ericysun/FrontierTrailCam/TrailCam Case/Device Photos/openDeviceView2.png

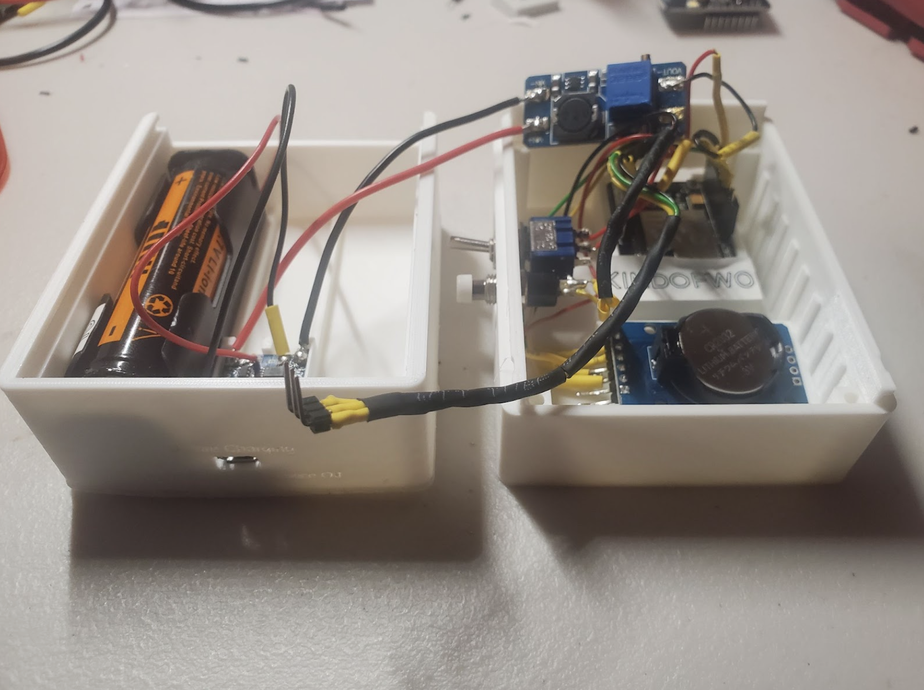
TrailCam Case/Device Photos/openDeviceView2.png
