ericysun/FrontierTrailCam/TrailCam Case/Device Photos/openDeviceView1.png

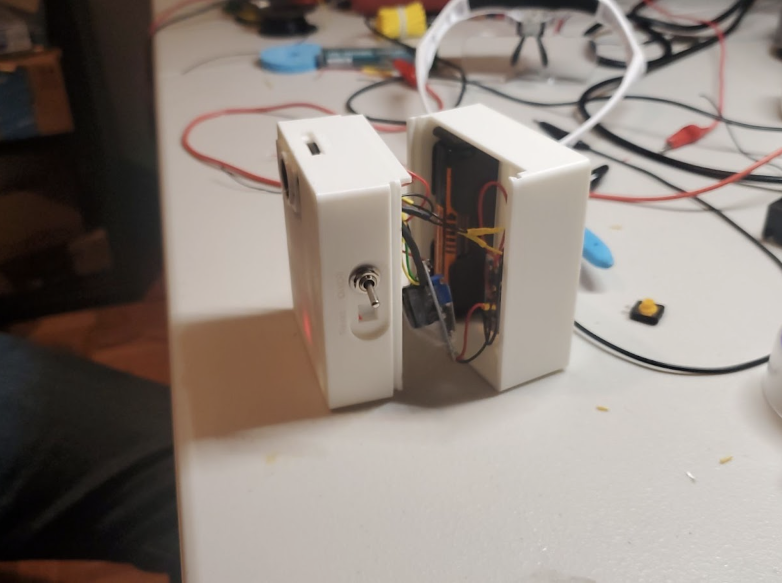
TrailCam Case/Device Photos/openDeviceView1.png
