ericysun/FrontierTrailCam/TrailCam Case/CAD Files/CameraCoverV5.obj

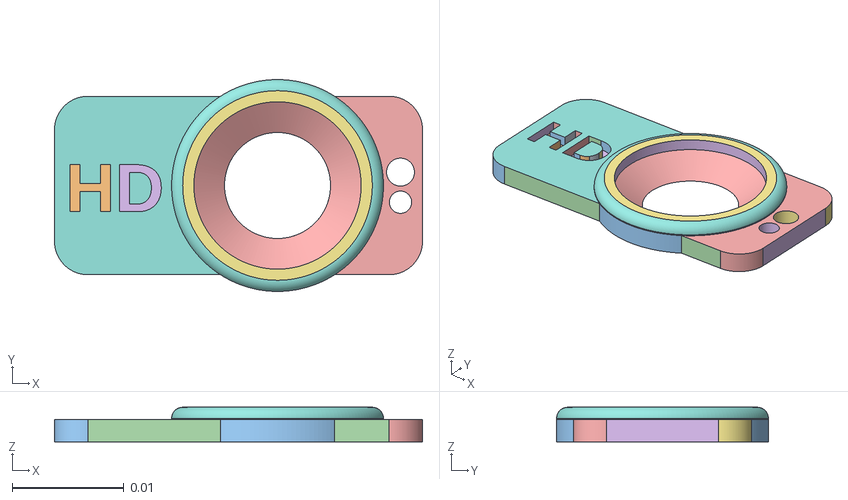
[picture p3: CAD file, 2024-10-31]
TrailCam Case/CAD Files/CameraCoverV5.obj
0.033 x 0.019 x 0.0031
