ericysun/FrontierTrailCam/(threads)

Thread 1 (2022-09-12):

Redirect to Web Server IP address for ESP-CAM

ericysun, 2022-09-12:
Set up Static IP: https://randomnerdtutorials.com/esp32-cam-static-fixed-ip-address-arduino/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,address%20as%20we%27ll%20explain.

Closed 2025-05-05.

Thread 2 (2022-09-12):

Photo Settings Page doesn't display previous settings

ericysun, 2022-09-12:
The photo settings page displays the current time as the start time and always displays "hour" as frequency, not reflecting the actual settings.

Closed 2025-05-04.

Thread 3 (2022-09-12):

Sleep Calculation not working for certain timezones

ericysun, 2022-09-12:
If the camera is used in an area with a with non-int difference from UTC in hours, the calculation for sleep time doesn't work. For example, if a timezone is UTC+1, it works, but if the timezone is UTC+1.5, it will not work.

Closed 2025-05-06.
