ericysun/FrontierTrailCam/TrailCam Case/Drafting Drawings/Battery Holder Drawing.pdf

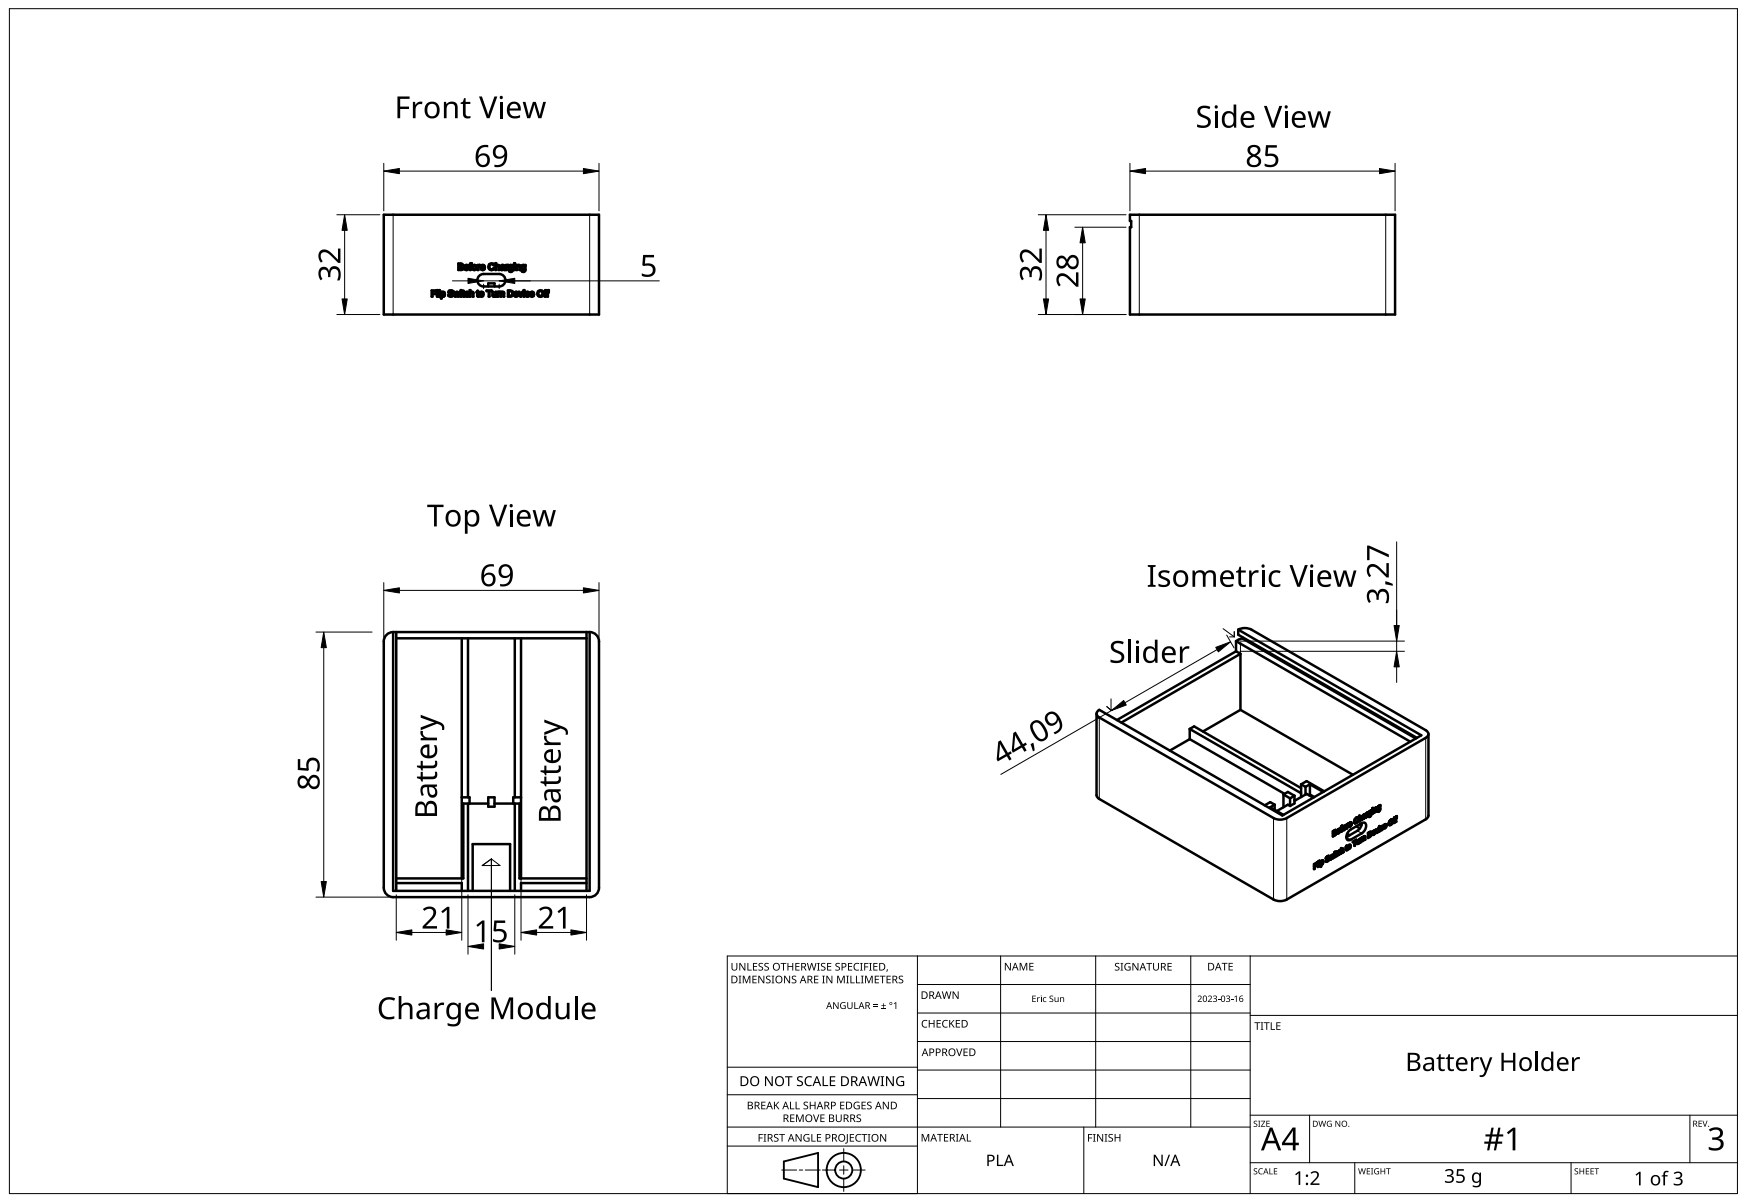
[picture p4: page 1]
