ericysun/FrontierTrailCam/TrailCam Case/Drafting Drawings/Camera Cover Drawing.pdf

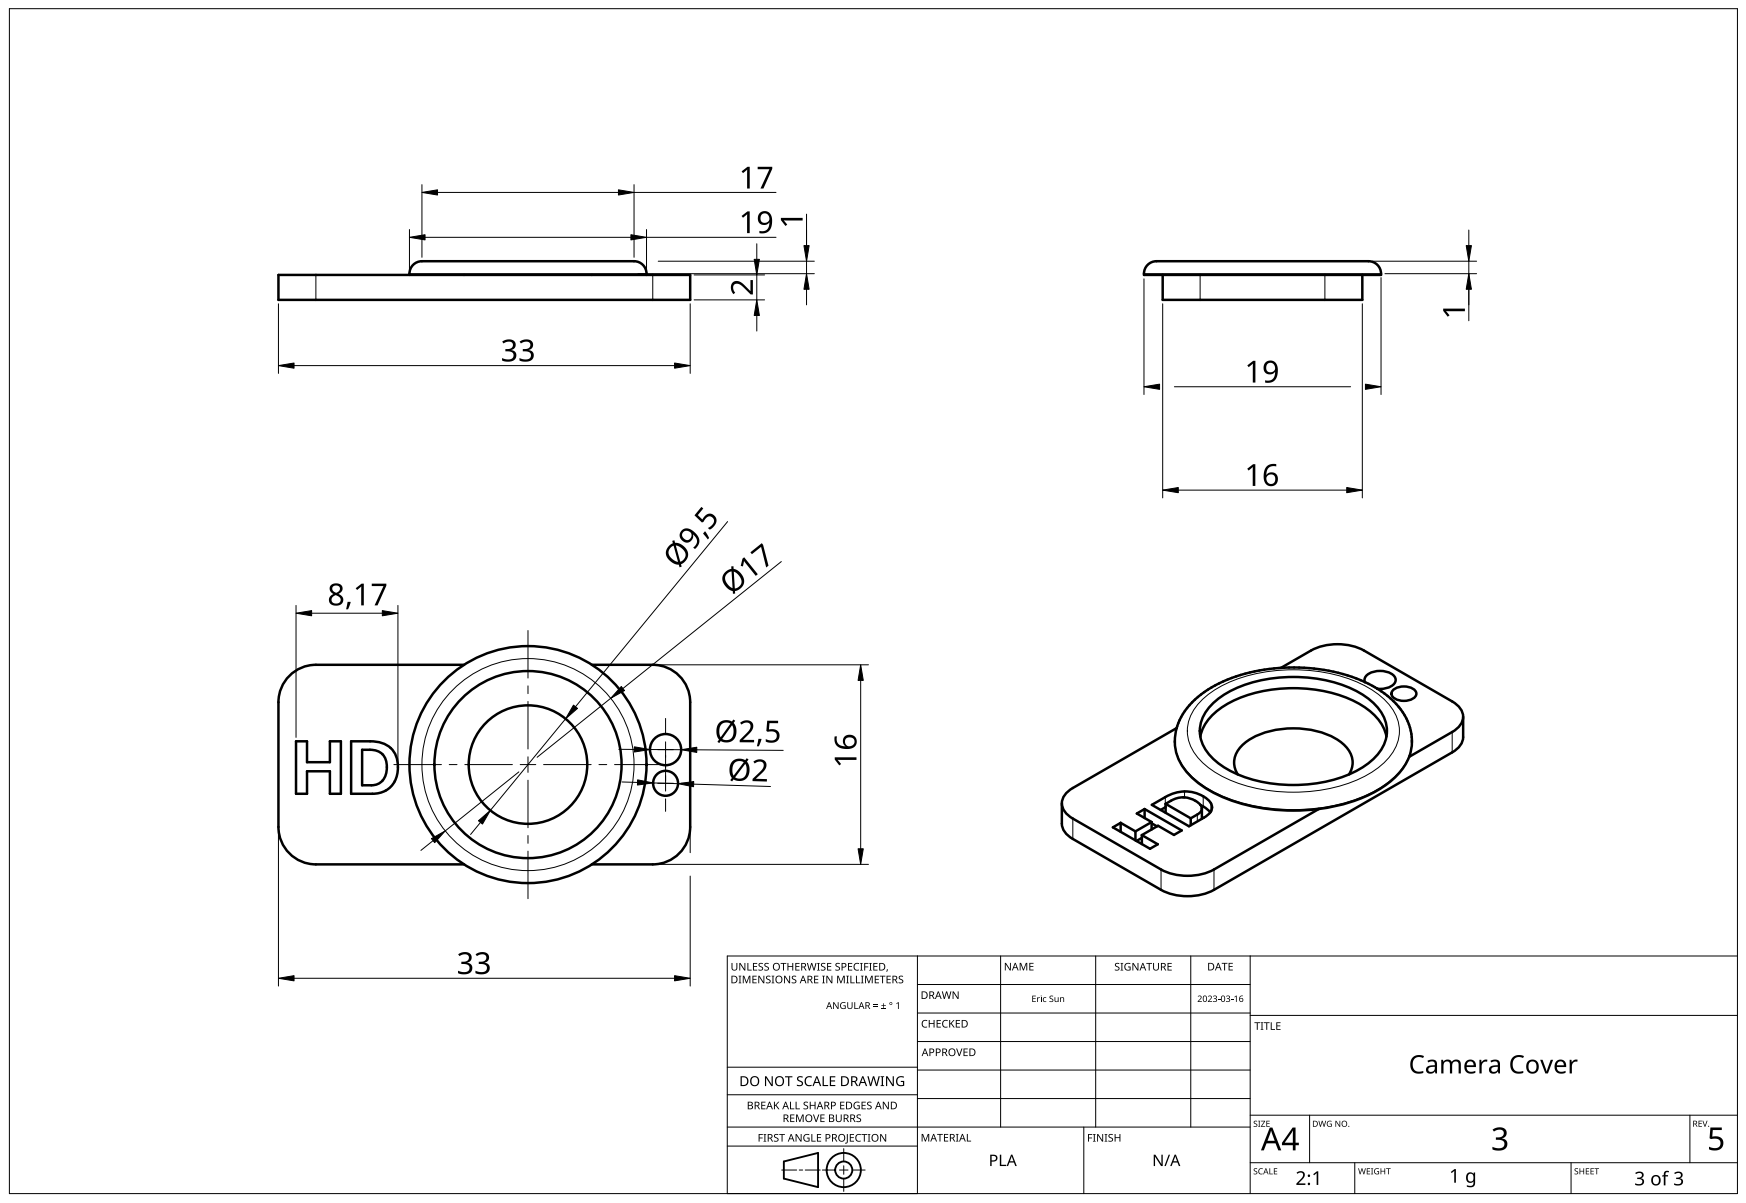
[picture p5: page 1]
