ericysun/FrontierTrailCam/TrailCam Case/Drafting Drawings/Top Part Drawing.pdf

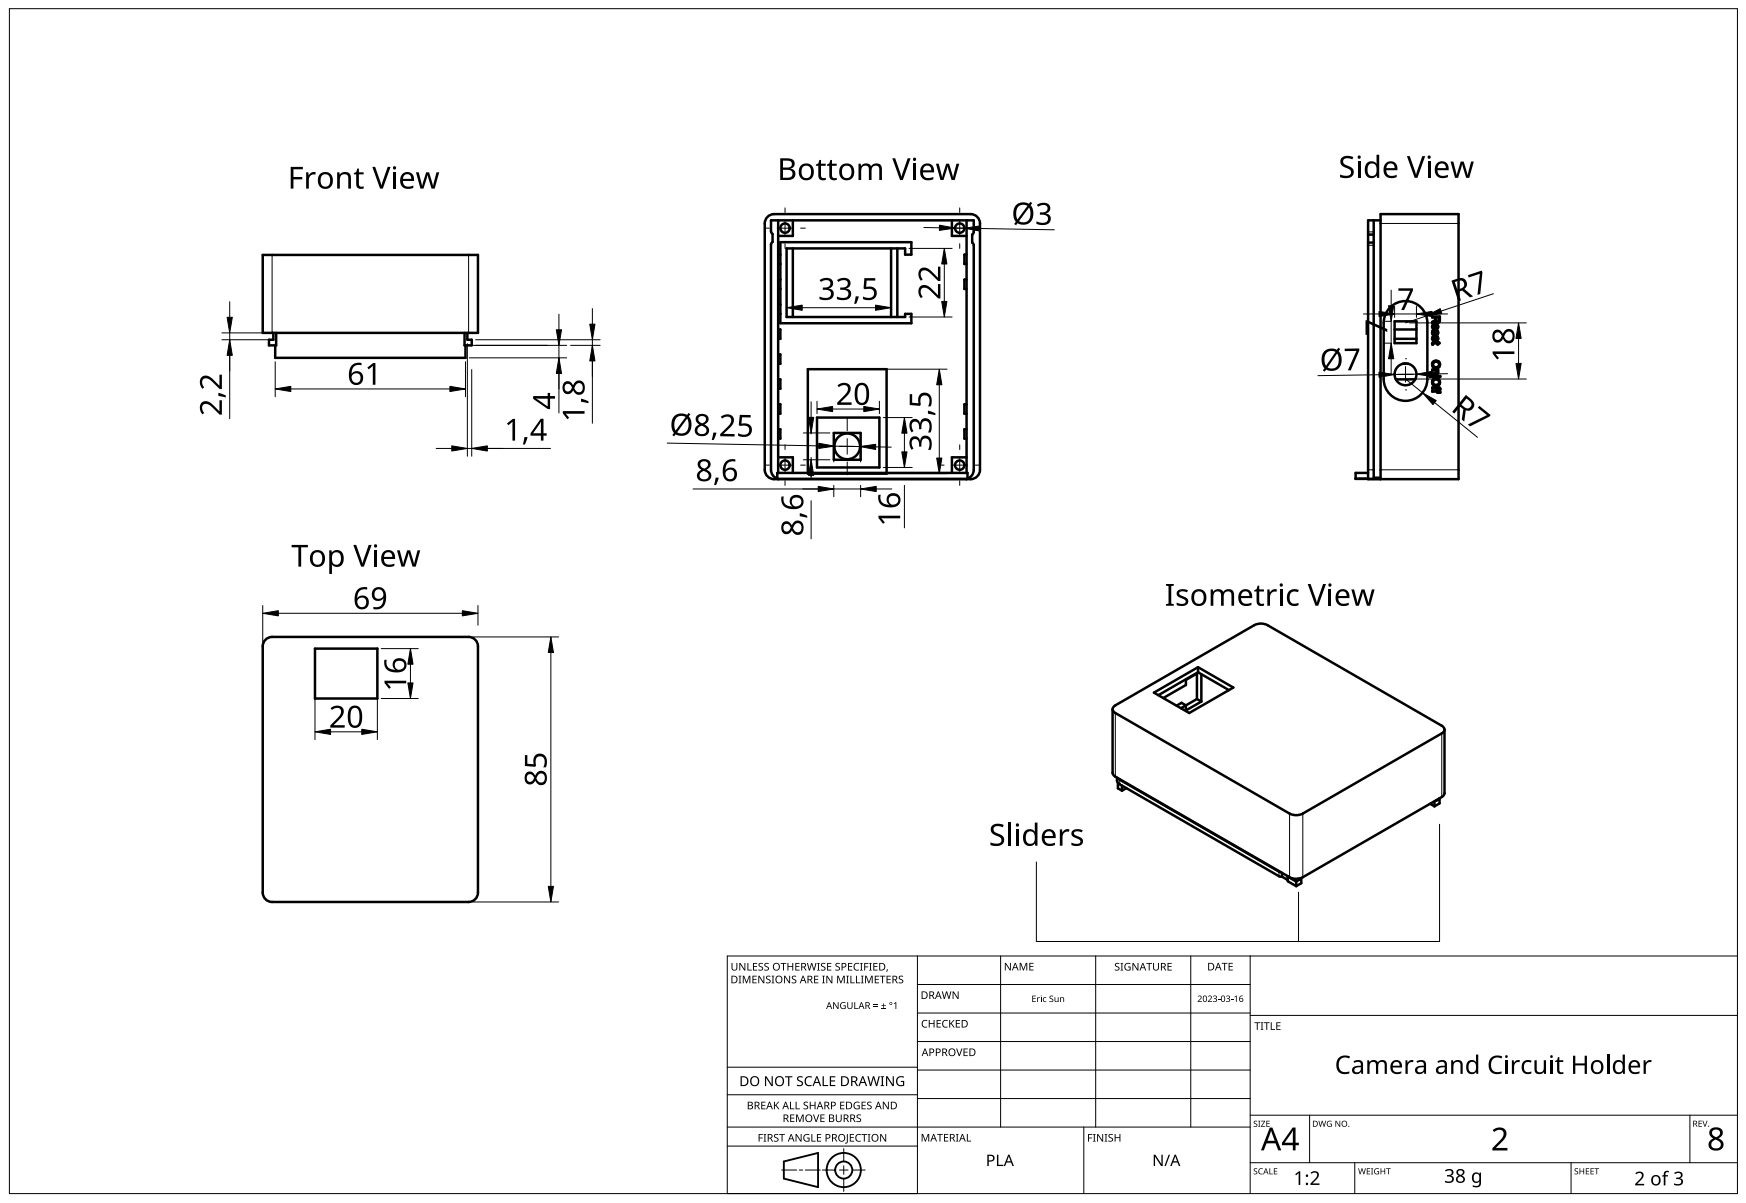
[picture p6: page 1]
