ericysun/FrontierTrailCam/camera_ap_storage/camera_index.h

//Note: More modern camera SOC assemblies may use the OV5640 sensor instead of OV2640. You may need to change this file accordingly.
//File: index_ov2640.html.gz, Size: 4316
#define index_ov2640_html_gz_len 18847//4316
const uint8_t index_ov2640_html_gz[] = {
0x1f,0x8b,0x08,0x08,0x50,0x49,0x26,0x63,0x00,0xff,0x69,0x6e,0x64,0x65,0x78,0x2e,0x68,0x74,0x6d,0x6c
,0x2e,0x67,0x7a,0x00,0xdd,0x5c,0x7b,0x73,0xda,0x4a,0xb2,0xff,0x3f,0x9f,0x62,0xac,0x9c,0x0d,0xd2,0xae
,0xc0,0x80,0x1d,0xdb,0x11,0x06,0x5f,0x1b,0x3b,0x39,0x5b,0x95,0xe4,0x9c,0x3d,0xce,0xbd,0xbb,0x55,0x5b
,0x5b,0x89,0x90,0x46,0xa0,0x58,0x48,0x1c,0x3d,0x78,0x84,0xe5,0x73,0xde,0xaf,0xb3,0xbf,0x79,0x48,0x48
,0x3c,0x6c,0x03,0x09,0x6c,0x1d,0xa8,0x02,0x69,0xd4,0xd3,0xd3,0xdd,0xbf,0xee,0x9e,0x87,0x34,0xba,0x3c
,0xb2,0x03,0x2b,0x9e,0x0c,0x28,0xe9,0xc5,0x7d,0xaf,0xf5,0xe2,0x52,0xfc,0x11,0x7c,0x2e,0x7b,0xd4,0xb4
,0xc5,0x21,0x3f,0xed,0xd3,0xd8,0x24,0x56,0xcf,0x0c,0x23,0x1a,0x37,0x95,0x24,0x76,0xca,0x17,0xca,0xe2
,0x65,0xdf,0xec,0xd3,0xa6,0x32,0x74,0xe9,0x68,0x10,0x84,0xb1,0x42,0xac,0xc0,0x8f,0xa9,0x0f,0xf2,0x91
,0x6b,0xc7,0xbd,0xa6,0x4d,0x87,0xae,0x45,0xcb,0xfc,0x44,0x77,0x7d,0x37,0x76,0x4d,0xaf,0x1c,0x59,0xa6
,0x47,0x9b,0x35,0x9d,0x24,0x11,0x0d,0xf9,0x99,0xd9,0x41,0xc1,0x84,0x46,0x79,0xf6,0xb1,0x1b,0x7b,0xb4
,0x75,0x1f,0x87,0xd4,0xec,0x97,0xdb,0x68,0x26,0x34,0xc9,0x7d,0x6c,0xc6,0x6e,0xe0,0x5f,0x1e,0x8b,0x8b
,0x73,0xe2,0x28,0x9e,0xb0,0xf3,0x4e,0x60,0x4f,0xa6,0x0e,0x44,0x28,0x3b,0x66,0xdf,0xf5,0x26,0xc6,0x75
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
,0x08,0x28,0xf2,0x86,0x33,0xb2,0x16,0x58,0x89,0xc3,0x56,0x0f,0x7d,0x57,0xe7,0x86,0x32,0x86,0x48,0x1f
,0x04,0x35,0xd5,0x1b,0x8e,0x4e,0x0f,0xeb,0x87,0xb4,0x2b,0xf0,0xf5,0xf5,0x40,0x18,0x01,0x8d,0x32,0x17
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
};
