ericysun/FrontierTrailCam/camera_ap_storage/acknowledgements.c

/*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
  For webserver UI styling:
  W3 Schools CSS resources

  PIN Layout and Hardware Info:
  https://lastminuteengineers.com/getting-started-with-esp32-cam/
*********/
